RIT-Launch-Initiative/SCRAP/Hardware/Production Files/BOM_Main SCRAP Board_SCRAP PCB_2023-08-25.xlsx

No. | Quantity | Comment | Designator | Footprint | Value | Manufacturer Part | Manufacturer | Supplier Part | Supplier | JLCPCB Price
1 | 1 | MY-1220-01 | BT1 | BAT-TH_MY-1220-01 |  | MY-1220-01 | MYOUNG(美阳) | C964817 | LCSC
2 | 1 | 2400Hz | BUZZER1 | BUZ-TH_BD12.0-P7.60-D0.6-FD | 2400Hz | TMB12A05 | YUEXIN(悦馨) | C781860 | LCSC
3 | 37 | 100nF | C1,C2,C5,C6,C8,C9,C11,C12,C17,C19,C20,C22,C23,C24,C25,C27,C29,C30,C34,C36,C37,C47,C48,C51,C53,C55,C57,C61,C62,C65,C88,C93,C95,C96,C99,C100,C101 | C0805 | 100nF | CL21B104KCFNNNE | SAMSUNG(三星) | C28233 | LCSC
4 | 14 | 10uF | C3,C10,C14,C15,C16,C18,C21,C41,C43,C45,C59,C87,C94,C97 | C0805 | 10uF | CL21A106KAYNNNE | SAMSUNG(三星) | C15850 | LCSC
5 | 5 | 1uF | C4,C7,C13,C26,C28 | C0805 | 1uF | CL21B105KBFNNNE | SAMSUNG(三星) | C28323 | LCSC
6 | 8 | 22uF | C31,C32,C39,C40,C63,C64,C98,C102 | CASE-B_3528 | 22uF | CA45-B-16V-22uF-K | CEC(振华新云) | C129568 | LCSC
7 | 9 | 4.7uF | C33,C35,C42,C44,C46,C52,C54,C56,C58 | C0805 | 4.7uF | CL21A475KAQNNNE | SAMSUNG(三星) | C1779 | LCSC
8 | 2 | 100uF | C38,C60 | CAP-SMD_L7.3-W4.3-R-RD | 100uF | T491D107K016AT | KEMET(基美) | C110548 | LCSC
9 | 2 | 30pF | C49,C50 | C0805 | 30pF | CC0805JRNPO9BN300 | YAGEO(国巨) | C107114 | LCSC
10 | 1 | SD-112S | CARD1 | SD-SMD_SD-112S |  | SD-112S | HANBO(汉博) | C961674 | LCSC
11 | 2 | B4B-PH-K-S(LF)(SN) | CN1,CN9 | CONN-TH_B4B-PH-K-S |  | B4B-PH-K-S(LF)(SN) | JST | C131334 | LCSC
12 | 4 | B2B-PH-K-S(LF)(SN) | CN2,CN3,CN4,CN6 | CONN-TH_B2B-PH-K-S |  | B2B-PH-K-S(LF)(SN) | JST | C131337 | LCSC
13 | 2 | SMD0805P002TF | F1,F6 | F0805 |  | SMD0805P002TF | PTTC(聚鼎) | C495352 | LCSC
14 | 2 | K1812L200DR | F2,F3 | F1812 |  | K1812L200DR | KUU | C2892439 | LCSC
15 | 2 | JK-nSMD100/16V | F4,F5 | F1206 |  | JK-nSMD100/16V | JK(金科) | C2830246 | LCSC
16 | 1 | PZ254R-11-03P | H2 | HDR-TH_3P-P2.54-H-M-W10.4 |  | PZ254R-11-03P | XFCN(兴飞) | C492411 | LCSC
17 | 1 | PM254-2-03-W-8.5 | ICSP1 | HDR-TH_6P-P2.54-H-F-R2-C3-W8.5-1 |  | PM254-2-03-W-8.5 | HCTL(华灿天禄) | C2897423 | LCSC
18 | 1 | 2.2uH | L1 | L0805 | 2.2uH | CMI201209U2R2KT | FH(风华) | C1043 | LCSC
19 | 1 | TPD8F003DQDR | L2 | WSON-16_L3.3-W1.4-P0.40-BL-EP | 8.5pF | TPD8F003DQDR | TI(德州仪器) | C473368 | LCSC
20 | 1 | 8.5pF | L3 | WSON-16_L3.3-W1.4-P0.40-BL-EP | 8.5pF | TPD8F003DQDR | TI(德州仪器) | C473368 | LCSC
21 | 1 | PT12-21B/TR8 | LED1 | OPTO-SMD_2P_PD12-21B-1 |  | PT12-21B/TR8 | EVERLIGHT(台湾亿光) | C264383 | LCSC
22 | 2 | LTST-S326KGJRKT | LED2,LED3 | LED-SMD_LTST-S326KGJRKT |  | LTST-S326KGJRKT | LITEON(光宝) | C125116 | LCSC
23 | 1 | NH-Z1921RGBA-SF | LED4 | LED-ARRAY-SMD_4P-L2.2-W2.1-BR |  | NH-Z1921RGBA-SF | 国星光电 | C2874119 | LCSC
24 | 5 | SMTWE2015MTJ | N1,N2,N3,N4,N5 | SMD_BD4.4-L4.4-D2.8 |  | SMTWE2015MTJ | Sinhoo(雄和远景) | C2928176 | LCSC
25 | 1 | S8550 | Q1 | SOT-23-3_L2.9-W1.6-P1.90-LS2.8-BR |  | S8550 | CJ（江苏长电/长晶） | C105432 | LCSC
26 | 1 | D882 Y档160~320 | Q2 | SOT-89-3_L4.5-W2.5-P1.50-LS4.2-BR |  | D882 Y档160~320 | CJ(江苏长电/长晶) | C9634 | LCSC
27 | 2 | SI2301CDS-T1-GE3 | Q3,Q5 | SOT-23-3_L3.0-W1.7-P0.95-LS2.9-BR |  | SI2301CDS-T1-GE3 | VISHAY(威世) | C10487 | LCSC
28 | 2 | MMBT2222A 1P | Q4,Q6 | SOT-23-3_L2.9-W1.3-P1.90-LS2.4-BR |  | MMBT2222A 1P | CJ(江苏长电/长晶) | C8512 | LCSC
29 | 1 | AO3401A | Q10 | SOT-23_L2.9-W1.3-P1.90-LS2.4-BR |  | AO3401A | AOS | C15127 | LCSC
30 | 28 | 10kΩ | R1,R2,R3,R5,R6,R7,R9,R10,R11,R19,R20,R21,R22,R25,R26,R42,R43,R44,R46,R48,R50,R79,R82,R83,R84,R90,R91,R92 | R0805 | 10kΩ | 0805W8F1002T5E | UNI-ROYAL(厚声) | C17414 | LCSC
31 | 2 | 47Ω | R4,R87 | R0805 | 47Ω | 0805W8F470JT5E | UNI-ROYAL(厚声) | C17714 | LCSC
32 | 3 | 120Ω | R8,R85,R86 | R0805 | 120Ω | 0805W8F1200T5E | UNI-ROYAL(厚声) | C17437 | LCSC
33 | 2 | CMF0805-103F3970 | R12,R40 | R0805 |  | CMF0805-103F3970 | 时恒 | C72672 | LCSC
34 | 2 | 0805W8F4701T5E | R13,R14 | R0805 |  | 0805W8F4701T5E | UNI-ROYAL(厚声) | C17673 | LCSC
35 | 2 | 20kΩ | R15,R28 | R0805 | 20kΩ | 0805W8F2002T5E | UNI-ROYAL(厚声) | C4328 | LCSC
36 | 1 | 8.2kΩ | R16 | R0805 | 8.2kΩ | 0805W8F8201T5E | UNI-ROYAL(厚声) | C17828 | LCSC
37 | 2 | 100Ω | R17,R18 | R0805 | 100Ω | 0805W8F1000T5E | UNI-ROYAL(厚声) | C17408 | LCSC
38 | 2 | 5.1kΩ | R23,R24 | R0805 | 5.1kΩ | 0805W8F5101T5E | UNI-ROYAL(厚声) | C27834 | LCSC
39 | 9 | 1kΩ | R27,R29,R30,R35,R38,R39,R47,R49,R51 | R0805 | 1kΩ | 0805W8F1001T5E | UNI-ROYAL(厚声) | C17513 | LCSC
40 | 1 | 47kΩ | R31 | R0805 | 47kΩ | 0805W8F4702T5E | UNI-ROYAL(厚声) | C17713 | LCSC
41 | 2 | 20Ω | R32,R33 | R1206 | 20Ω | 1206W4F200JT5E | UNI-ROYAL(厚声) | C17955 | LCSC
42 | 3 | 100mΩ | R34,R52,R53 | R1206 | 100mΩ | 1206W4F100LT5E | UNI-ROYAL(厚声) | C25334 | LCSC
43 | 1 | 2kΩ | R36 | R0805 | 2kΩ | 0805W8F2001T5E | UNI-ROYAL(厚声) | C17604 | LCSC
44 | 4 | 100kΩ | R37,R41,R88,R89 | R0805 | 100kΩ | 0805W8F1003T5E | UNI-ROYAL(厚声) | C149504 | LCSC
45 | 1 | 300kΩ | R45 | R0805 | 300kΩ | 0805W8F3003T5E | UNI-ROYAL(厚声) | C17616 | LCSC
46 | 5 | 0Ω | R55,R57,R58,R59,R60 | R1206 | 0Ω | 1206W4F0000T5E | UNI-ROYAL(厚声) | C17888 | LCSC
47 | 1 | HJ-SMA206 | RF1 | SMA-TH_HJ-SMA206 |  | HJ-SMA206 | 皇捷 | C2874829 | LCSC
48 | 1 | DS1133-S60BPX | RJ1 | RJ11-TH_DS1133-S60BPX |  | DS1133-S60BPX | CONNFLY | C77859 | LCSC
49 | 2 | Mini Power Switch | SW5,SW6 | FINGERTECH MINI POWER SWITCH 2 |  | Mini Power Switch | Fingertech | Mini Power Switch | Digi-Key
50 | 3 | SPVQ810302 | SW7,SW8,SW9 | SW-TH_SPVQ810302 |  | SPVQ810302 | ALPSALPINE(阿尔卑斯阿尔派) | C470664 | LCSC
51 | 1 | SRV05-4-P-T7 | TV1 | SOT-23-6_L2.9-W1.6-P0.95-LS2.8-BR |  | SRV05-4-P-T7 | PROTEK | C85364 | LCSC
52 | 1 | MMA8451QR1 | U1 | QFN-16_L3.0-W3.0-P0.50-TL_FXOS8700CQR1 |  | MMA8451QR1 | NXP(恩智浦) | C118083 | LCSC
53 | 2 | W25Q128JVSIQ | U2,U4 | SOIC-8_L5.3-W5.3-P1.27-LS8.0-BL |  | W25Q128JVSIQ | WINBOND(华邦) | C97521 | LCSC
54 | 2 | MAX3485AEASA+T | U3,U27 | SO-8_L4.9-W3.9-P1.27-LS5.9-BL |  | MAX3485AEASA+T | MAXIM(美信) | C94609 | LCSC
55 | 1 | MS560702BA03-50 | U5 | SENSOR-SMD_MS560702BA03-50 |  | MS560702BA03-50 | TE Connectivity(美国泰科) | C97627 | LCSC
56 | 1 | SHTC3 | U6 | SENSORM-SMD_4P-L2.0-W2.0-P1.00 |  | SHTC3 | Sensirion(瑞士盛思锐) | C194656 | LCSC
57 | 1 | HX4004A-MFC | U7 | SOT-23-6_L2.9-W1.6-P0.95-LS2.8-BR |  | HX4004A-MFC | HEXIN(禾芯微) | C172355 | LCSC
58 | 1 | HX711 | U8 | SOP-16_L10.0-W3.9-P1.27-LS6.0-BL |  | HX711 | AVIA(海芯科技) | C43656 | LCSC
59 | 1 | DS1302Z+T&R | U9 | SOIC-8_L4.9-W3.9-P1.27-LS6.0-BL |  | DS1302Z+T&R | MAXIM(美信) | C8959 | LCSC
60 | 1 | LIS3MDLTR | U10 | LGA-12_L2.0-W2.0-P0.50-BL |  | LIS3MDLTR | ST(意法半导体) | C478483 | LCSC
61 | 1 | LSM6DSLTR | U11 | LGA-14_L3.0-W2.5-P0.50-TL |  | LSM6DSLTR | ST(意法半导体) | C126672 | LCSC
62 | 1 | CP2102N-A02-GQFN28R | U12 | QFN-28_L5.0-W5.0-P0.50-TL-EP3.3 |  | CP2102N-A02-GQFN28R | SILICON LABS(芯科) | C964632 | LCSC
63 | 3 | INA219AIDR | U13,U19,U21 | SOIC-8_L4.9-W3.9-P1.27-LS6.0-BL |  | INA219AIDR | TI(德州仪器) | C138706 | LCSC
64 | 1 | LDL1117S33R | U14 | SOT-223-4_L6.5-W3.5-P2.30-LS7.0-BR |  | LDL1117S33R | ST(意法半导体) | C435835 | LCSC
65 | 1 | XB8089D | U15 | SOIC-8_L5.0-W4.0-P1.27-LS6.0-BL-EP2.0 |  | XB8089D | xysemi(赛芯微) | C79928 | LCSC
66 | 1 | MCP73871T-2CCI/ML | U16 | QFN-20_L4.0-W4.0-P0.5-BL-EP |  | MCP73871T-2CCI/ML | MICROCHIP(美国微芯) | C511310 | LCSC
67 | 1 | ATMEGA2560-16AU | U17 | TQFP-100_L14.0-W14.0-P0.50-LS16.0-BL |  | ATMEGA2560-16AU | MICROCHIP(美国微芯) | C22460 | LCSC
68 | 1 | SN74AHCT1G125DBVR | U18 | SOT-23-5_L3.0-W1.7-P0.95-LS2.8-BR |  | SN74AHCT1G125DBVR | TI(德州仪器) | C7484 | LCSC
69 | 1 | AMS1117-5.0 | U20 | SOT-223_L6.5-W3.5-P2.30-LS7.0-BR |  | AMS1117-5.0 | AMS | C6187 | LCSC
70 | 1 | RFM95W | U26 | COMM-SMD_RFM95W |  | RFM95W |  | C9900000484 | LCSC
71 | 1 | KH-TYPE-C-16P | USB1 | USB-C-SMD_KH-TYPE-C-16P |  | KH-TYPE-C-16P | kinghelm(金航标) | C709357 | LCSC
72 | 1 | 32.768kHz | X1 | FC-135R_L3.2-W1.5 | 12.5pF | Q13FC1350000400 | EPSON(爱普生) | C32346 | LCSC
73 | 1 | 8MHz | X2 | CRYSTAL-SMD_L5.0-W3.2 | 8MHz | X50328MSB2GI | YXC(扬兴晶振) | C115962 | LCSC
