RIT-Launch-Initiative/SCRAP/Hardware/SCH_SCRAP Schematic_2023-08-25.pdf

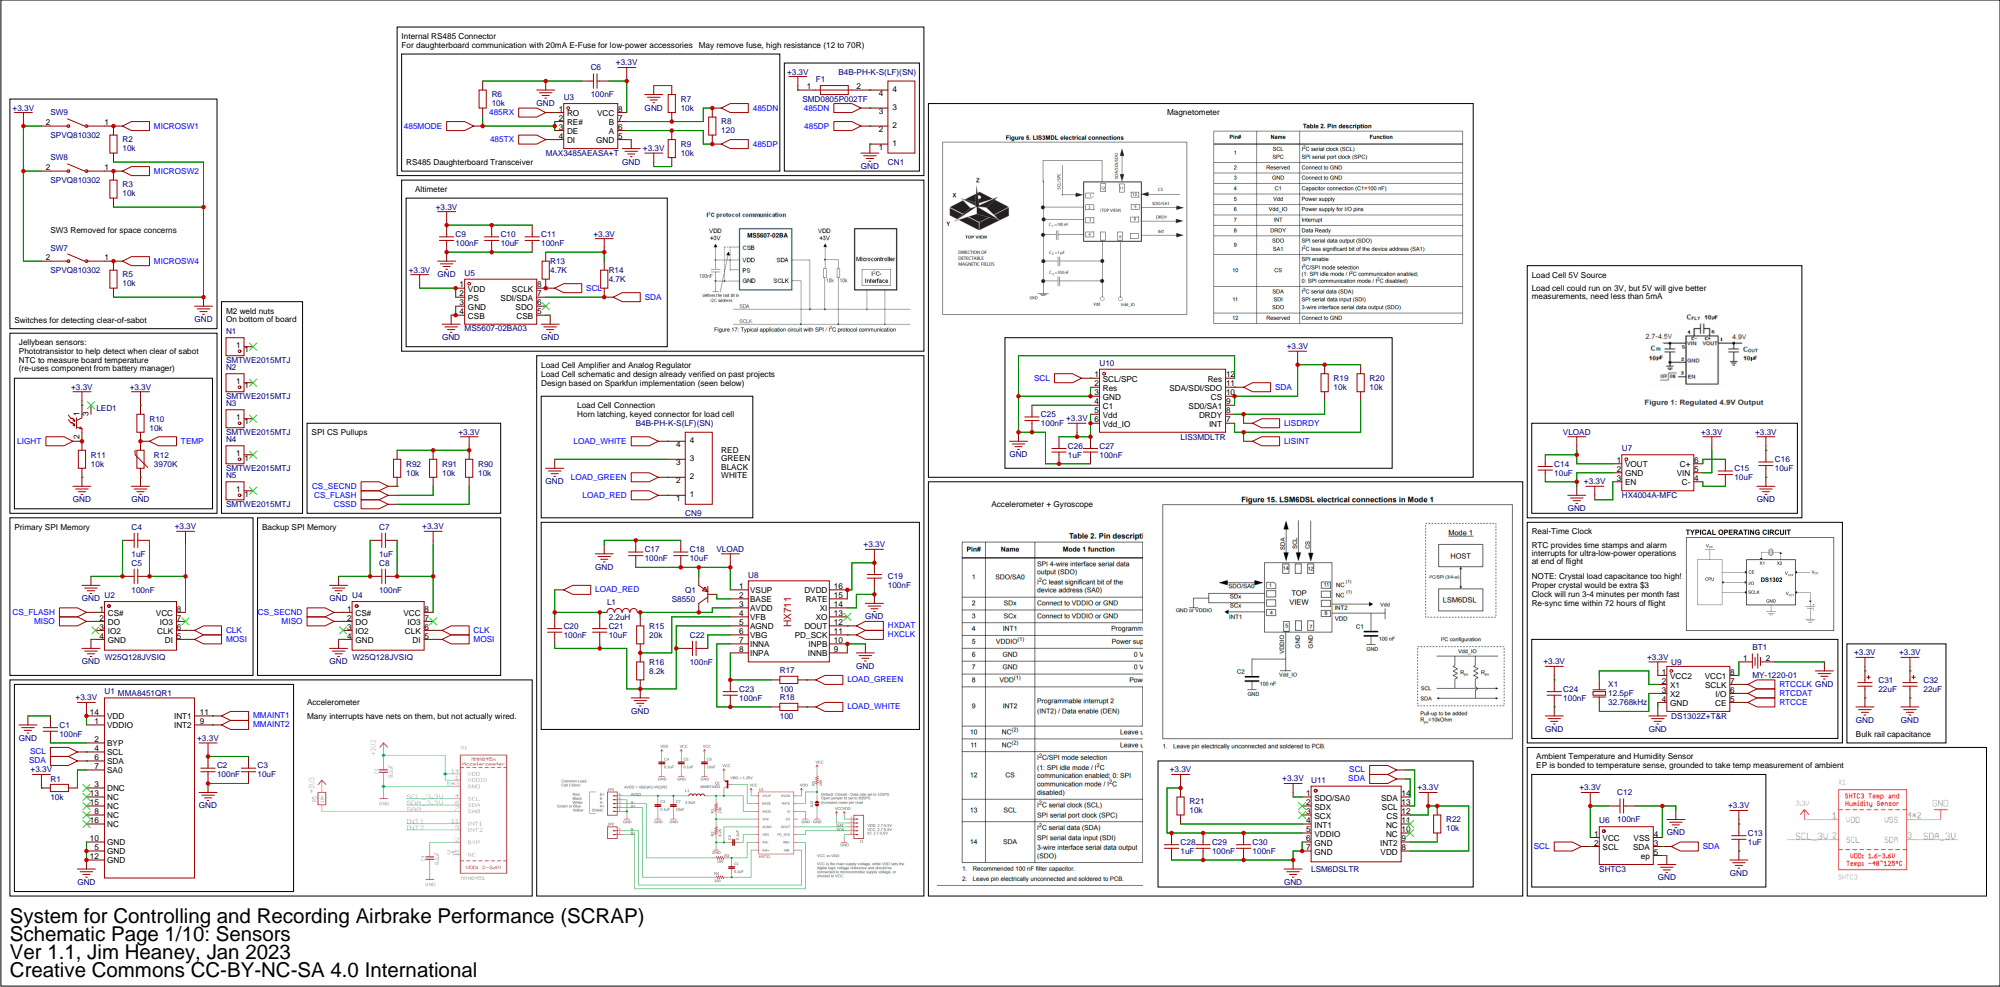
[picture p1: page 1]

Internal RS485 Connector
For daughterboard communication with 20mA E-Fuse for low-power accessories May remove fuse, high resistance (12 to 70R)

Load Cell 5V Source
Load cell could run on 3V, but 5V will give better
measurements, need less than 5mA

Switches for detecting clear-of-sabot

Jellybean sensors:
Phototransistor to help detect when clear of sabot
NTC to measure board temperature
(re-uses component from battery manager)

Load Cell Amplifier and Analog Regulator
Load Cell schematic and design already verified on past projects
Design based on Sparkfun implementation (seen below)

Load Cell Connection
Horn latching, keyed connector for load cell

Real-Time Clock
RTC provides time stamps and alarm
interrupts for ultra-low-power operations
at end of flight
NOTE: Crystal load capacitance too high!
Proper crystal would be extra $3
Clock will run 3-4 minutes per month fast
Re-sync time within 72 hours of flight

INPB 10 PD_SCK 11 DOUT 12 XO 13 XI 14 RATE 15 DVDD 16

Accelerometer
Many interrupts have nets on them, but not actually wired.

Ambient Temperature and Humidity Sensor
EP is bonded to temperature sense, grounded to take temp measurement of ambient

GND
System for Controlling and Recording Airbrake Performance (SCRAP)
Schematic Page 1/10: Sensors
Ver 1.1, Jim Heaney, Jan 2023
Creative Commons CC-BY-NC-SA 4.0 International

+ - -

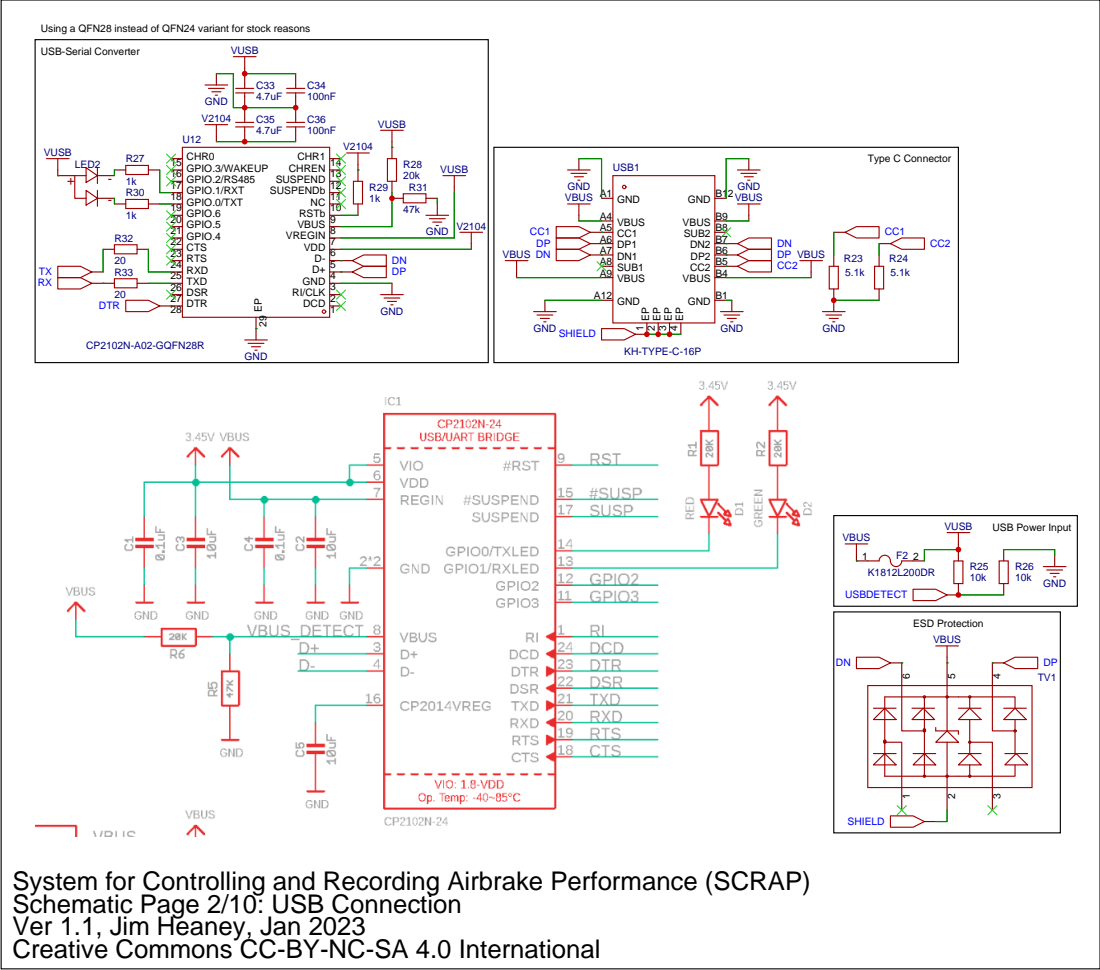
[picture p2: page 2]

Using a QFN28 instead of QFN24 variant for stock reasons
USB-Serial Converter

GND
CHR1 14 CHR0 15 GPIO.3/WAKEUP 16 GPIO.2/RS485 17 GPIO.1/RXT 18 GPIO.0/TXT 19 GPIO.6 20

21 GPIO.5
GPIO.4 22 CTS 23 RTS 24 RXD 25 TXD 26 DSR 27 DTR 28

System for Controlling and Recording Airbrake Performance (SCRAP)
Schematic Page 2/10: USB Connection

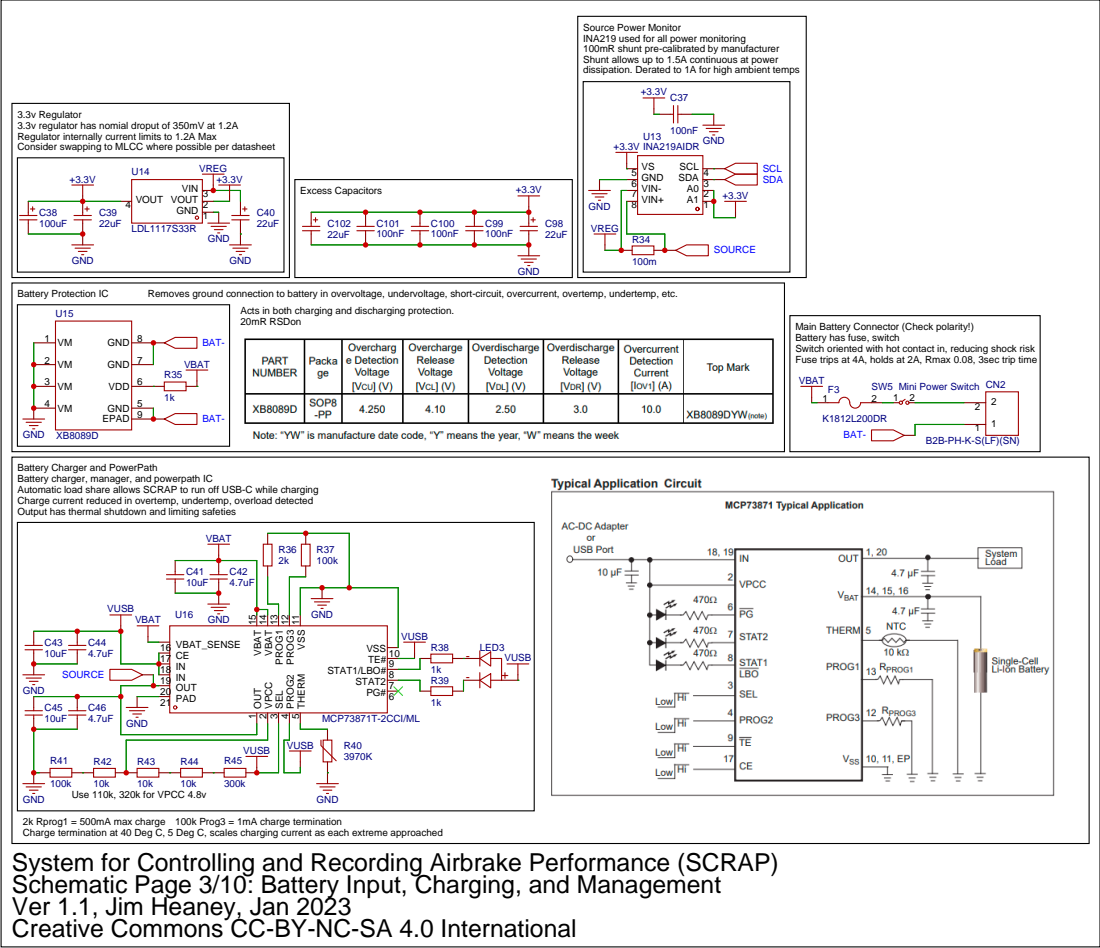
[picture p3: page 3]

Source Power Monitor
INA219 used for all power monitoring
100mR shunt pre-calibrated by manufacturer
Shunt allows up to 1.5A continuous at power
dissipation. Derated to 1A for high ambient temps

3.3v Regulator
3.3v regulator has nomial droput of 350mV at 1.2A
Regulator internally current limits to 1.2A Max
Consider swapping to MLCC where possible per datasheet

Removes ground connection to battery in overvoltage, undervoltage, short-circuit, overcurrent, overtemp, undertemp, etc.

Main Battery Connector (Check polarity!)
Battery has fuse, switch
Switch oriented with hot contact in, reducing shock risk
Fuse trips at 4A, holds at 2A, Rmax 0.08, 3sec trip time
VBAT
BAT-

Battery Charger and PowerPath
Battery charger, manager, and powerpath IC
Automatic load share allows SCRAP to run off USB-C while charging
Charge current reduced in overtemp, undertemp, overload detected
Output has thermal shutdown and limiting safeties

Use 110k, 320k for VPCC 4.8v
System for Controlling and Recording Airbrake Performance (SCRAP)
Schematic Page 3/10: Battery Input, Charging, and Management

GND
2k Rprog1 = 500mA max charge 100k Prog3 = 1mA charge termination
Charge termination at 40 Deg C, 5 Deg C, scales charging current as each extreme approached

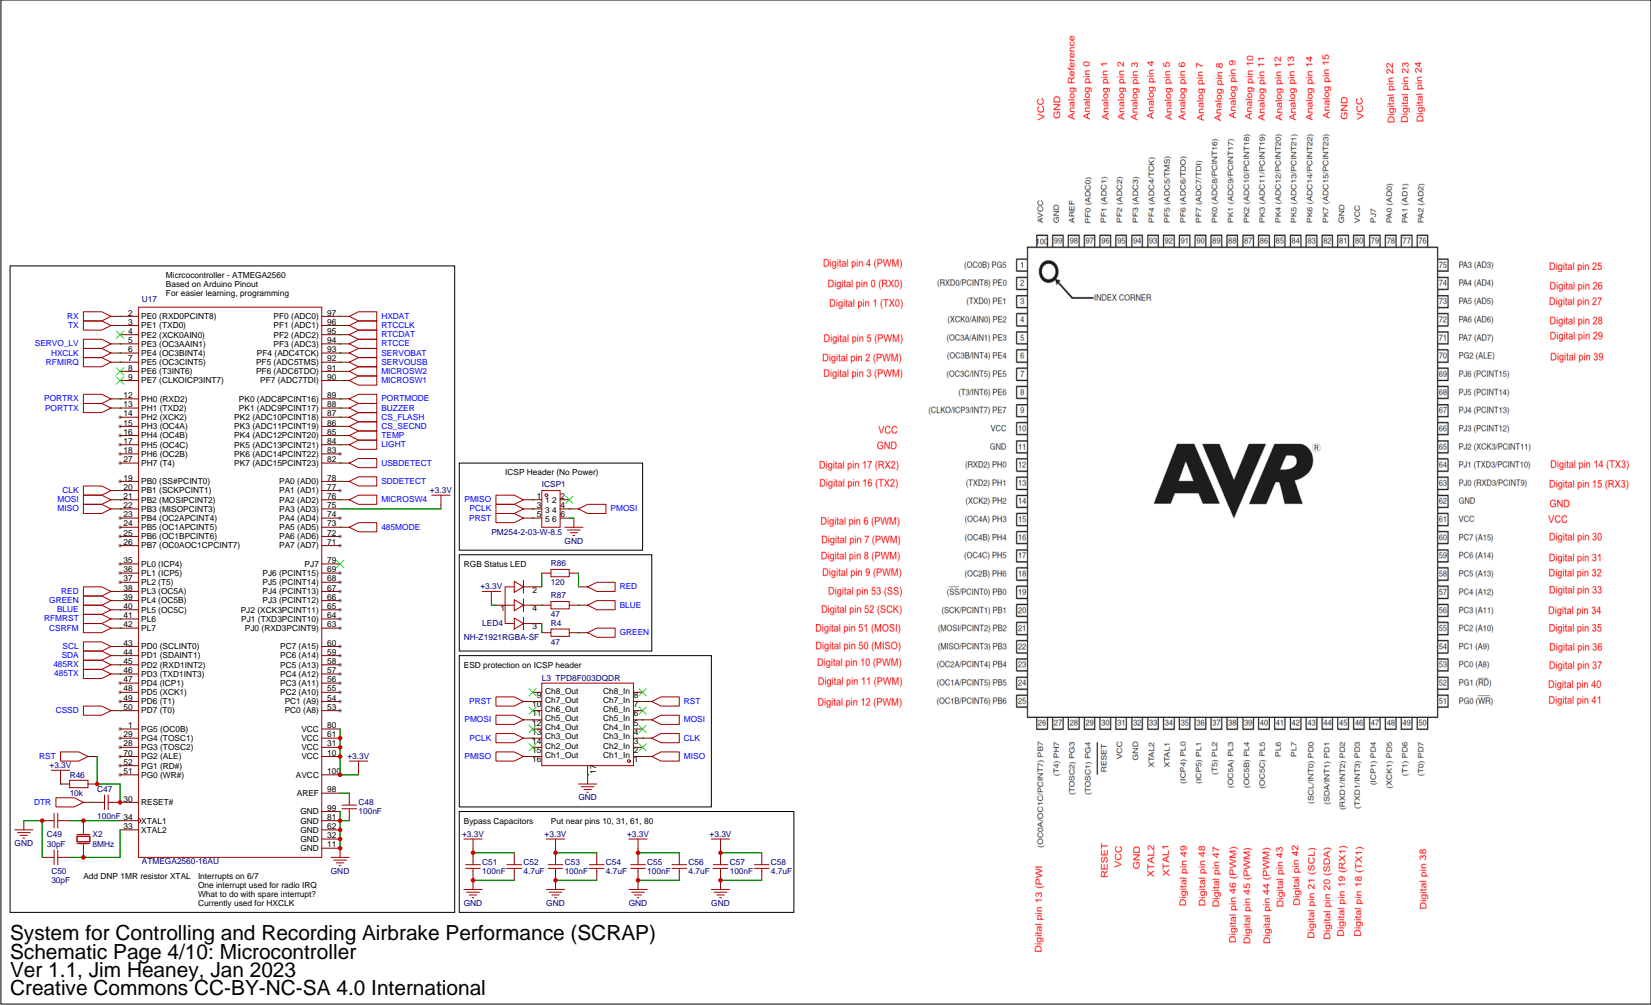
[picture p4: page 4]

ICSP Header (No Power)

ESD protection on ICSP header

Add DNP 1MR resistor XTAL
System for Controlling and Recording Airbrake Performance (SCRAP)
Schematic Page 4/10: Microcontroller

Interrupts on 6/7
One interrupt used for radio IRQ
What to do with spare interrupt?
Currently used for HXCLK

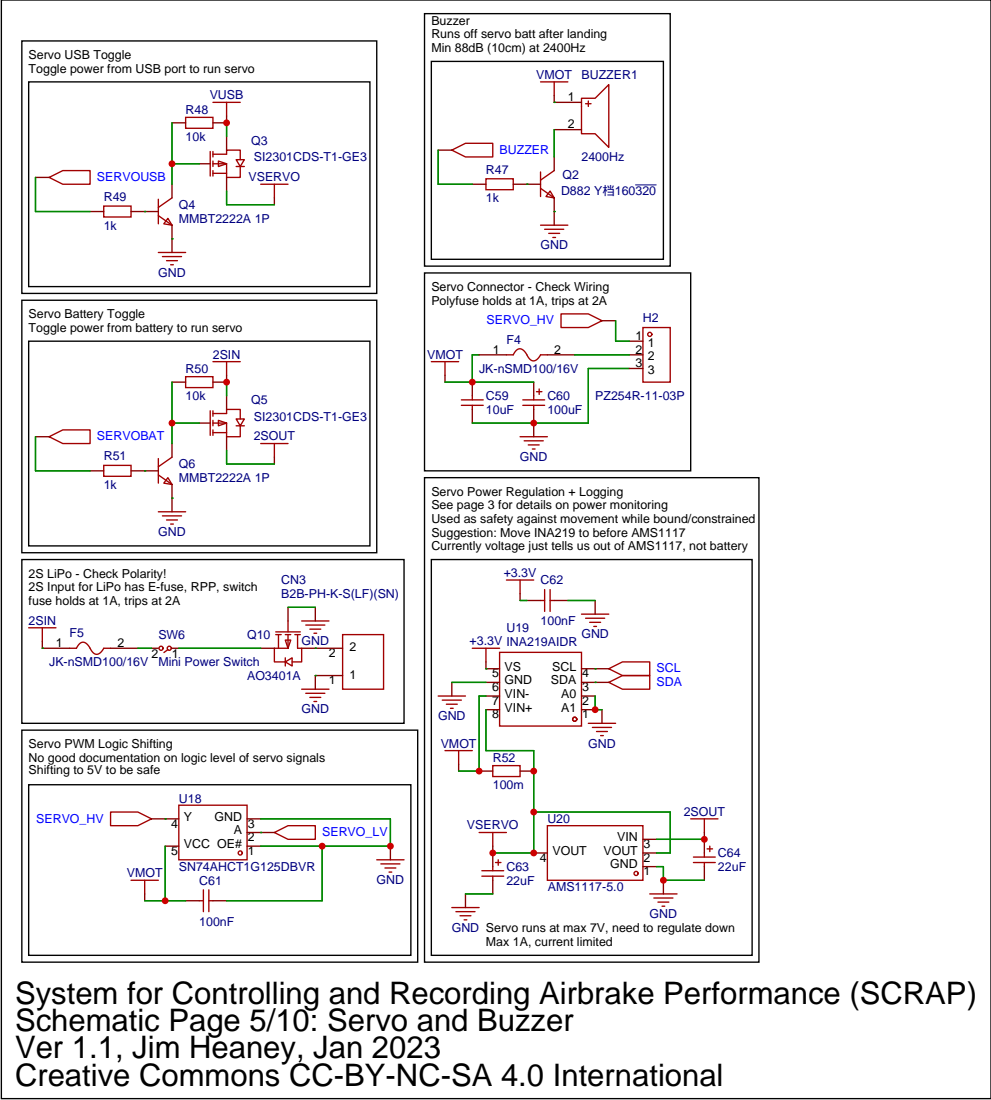
[picture p5: page 5]

Buzzer
Runs off servo batt after landing
Min 88dB (10cm) at 2400Hz

Servo USB Toggle
Toggle power from USB port to run servo

Servo Connector - Check Wiring
Polyfuse holds at 1A, trips at 2A

Servo Battery Toggle
Toggle power from battery to run servo

Servo Power Regulation + Logging
See page 3 for details on power monitoring
Used as safety against movement while bound/constrained
Suggestion: Move INA219 to before AMS1117
Currently voltage just tells us out of AMS1117, not battery

2S LiPo - Check Polarity!
2S Input for LiPo has E-fuse, RPP, switch
fuse holds at 1A, trips at 2A
2SIN
JK-nSMD100/16V 2 1

Servo PWM Logic Shifting
No good documentation on logic level of servo signals
Shifting to 5V to be safe

GND
Servo runs at max 7V, need to regulate down
Max 1A, current limited

System for Controlling and Recording Airbrake Performance (SCRAP)
Schematic Page 5/10: Servo and Buzzer

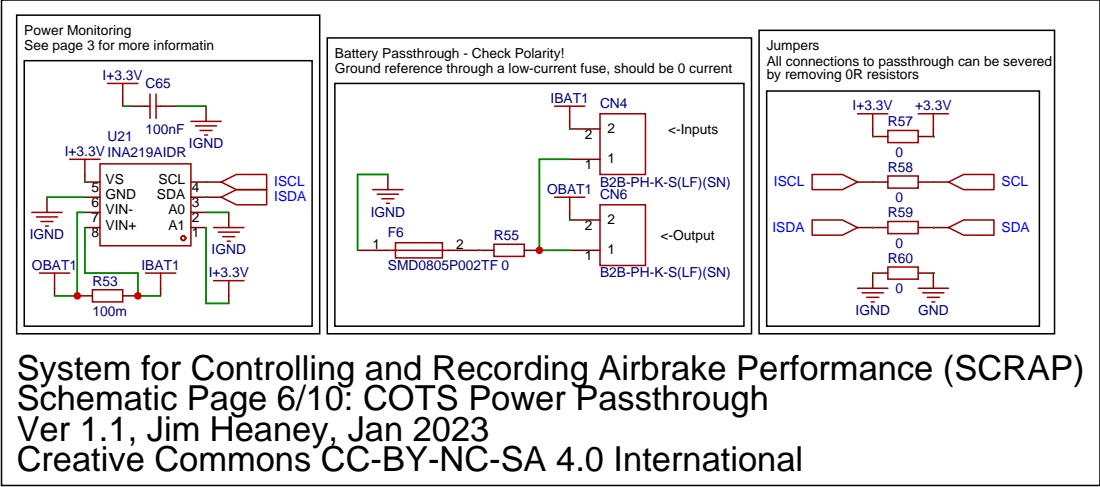
[picture p6: page 6]

Power Monitoring
See page 3 for more informatin

Jumpers
All connections to passthrough can be severed

Battery Passthrough - Check Polarity!
by removing 0R resistors Ground reference through a low-current fuse, should be 0 current

System for Controlling and Recording Airbrake Performance (SCRAP)
Schematic Page 6/10: COTS Power Passthrough
Ver 1.1, Jim Heaney, Jan 2023
Creative Commons CC-BY-NC-SA 4.0 International

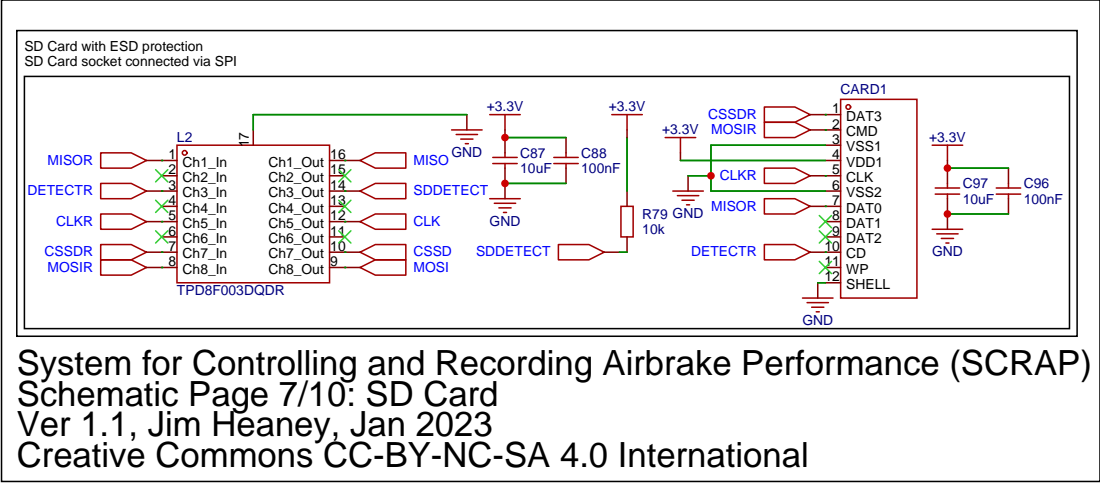
[picture p7: page 7]

SD Card with ESD protection
SD Card socket connected via SPI

MISOR
DETECTR
CLKR
CSSDR
MOSIR
System for Controlling and Recording Airbrake Performance (SCRAP)
Schematic Page 7/10: SD Card
Ver 1.1, Jim Heaney, Jan 2023
Creative Commons CC-BY-NC-SA 4.0 International

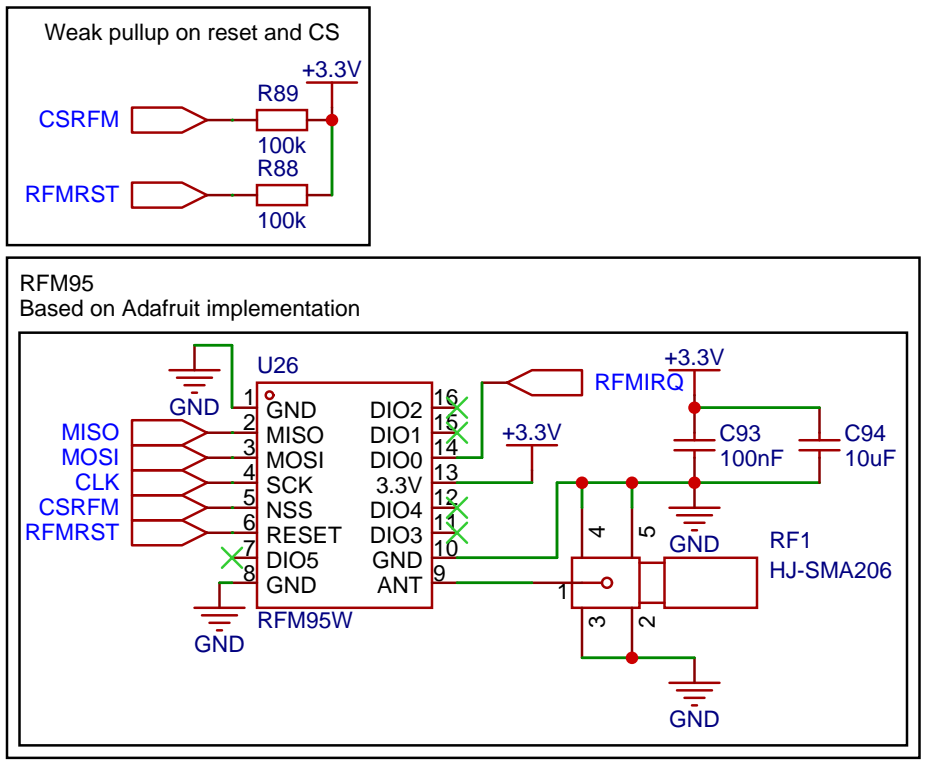
[picture p8: figure]
GND 1 MISO 2 MOSI 3 SCK 4 NSS 5 RESET 6 DIO5 7 GND 8; ANT 9; RFM95W; RF1 HJ-SMA206; GND; MISO MOSI CLK; RFMRST; CSRFM; RFMIRQ; Weak pullup on reset and CS; RFM95 Based on Adafruit implementation

# GND 10 DIO3 11 DIO4 12 3.3V 13 DIO0 14 DIO1 15 DIO2 16

# System for Controlling and Recording Airbrake Performance (SCRAP) Schematic Page 8/10: 900MHz Radio Ver 1.1, Jim Heaney, Jan 2023

GND 29 XI/CLKIN 30 XO 31 SCSn 32 SCLK 33 MISO 34 MOSI 35 INTn 36 RSTn 37 RSVD 38 RSVD 39 RSVD 40 RSVD 41 RSVD 42 PMODE2 43 PMODE1 44 PMODE0 45 NC 46 NC 47

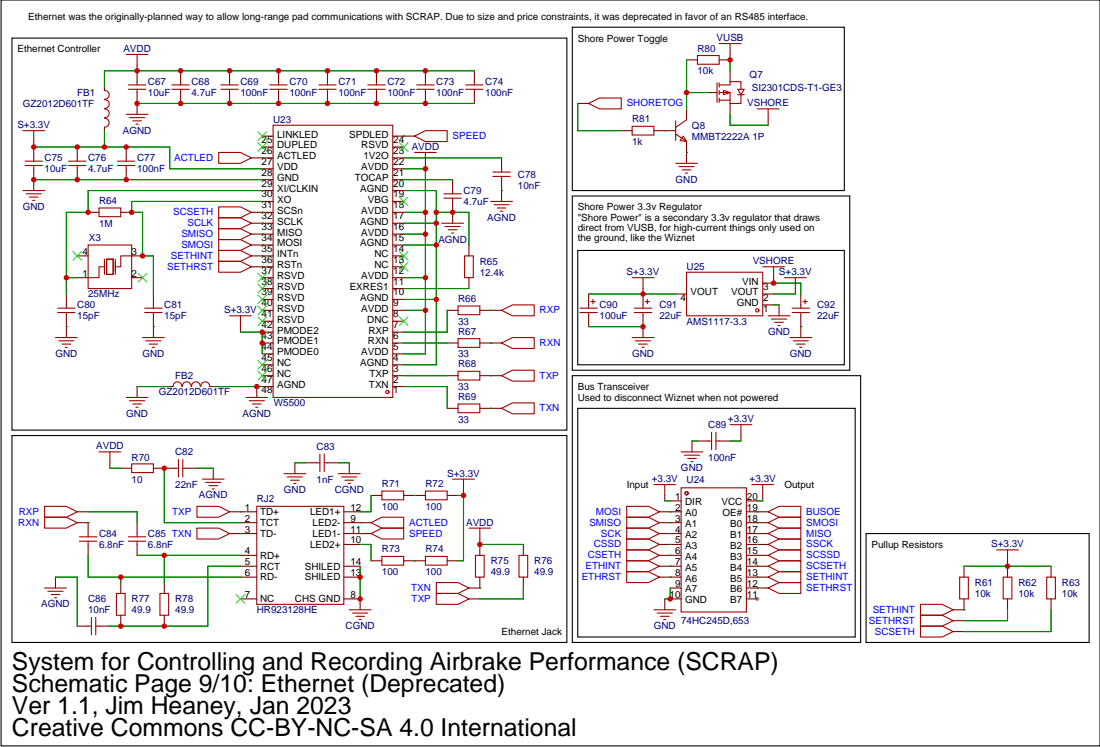
[picture p9: page 9]

Ethernet was the originally-planned way to allow long-range pad communications with SCRAP. Due to size and price constraints, it was deprecated in favor of an RS485 interface.

Shore Power 3.3v Regulator
"Shore Power" is a secondary 3.3v regulator that draws
direct from VUSB, for high-current things only used on
the ground, like the Wiznet

TXP
Bus Transceiver
Used to disconnect Wiznet when not powered
TXN

System for Controlling and Recording Airbrake Performance (SCRAP)
Schematic Page 9/10: Ethernet (Deprecated)

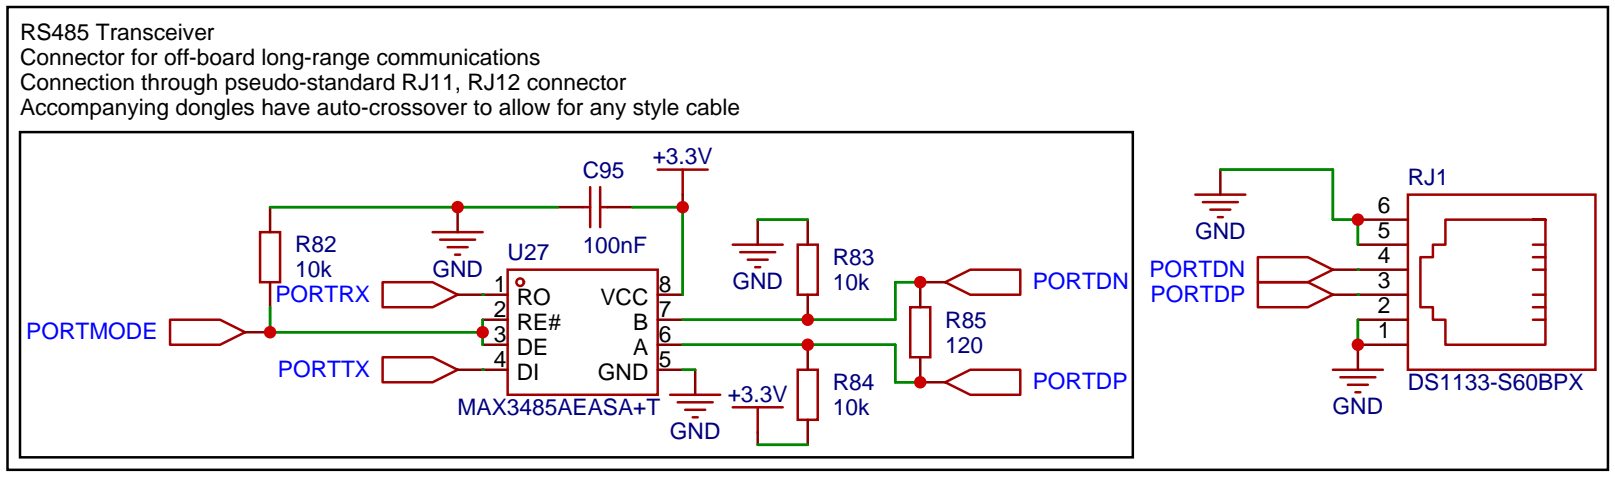
[picture p10: figure]
GND 5; VCC 8; MAX3485AEASA+T; RS485 Transceiver; 10k PORTRX; PORTMODE; PORTTX; GND; PORTDN; PORTDP; PORTDN PORTDP; DS1133-S60BPX; Connector for off-board long-range communications

Connection through pseudo-standard RJ11, RJ12 connector Accompanying dongles have auto-crossover to allow for any style cable

# System for Controlling and Recording Airbrake Performance (SCRAP) Schematic Page 10/10: Pad RS485 Ver 1.1, Jim Heaney, Jan 2023 Creative Commons CC-BY-NC-SA 4.0 International
