RIT-Launch-Initiative/SCRAP/(commit log)

2023-08-25 Added production files
    [BOM_Main SCRAP Board_SCRAP PCB_2023-08-25.xlsx, PickAndPlace_SCRAP PCB_2023-08-25.xlsx]
2023-08-25 Added EasyEDA Pro files, schematic
